aa236b-winter-2019/electrical-documentation/PandaSat Electronics.pptx

T+C Radio

Batteries

8.4 V

PMU

> 8.4V, 6W

Burn Wire Ckt

Solar panels

Burn Wires

Torque Coils

Solar Panels

Gryo/Mag

Flash Memory

MotherBoard

Data

SAMD51

Data & Power

Raspberry
PI

H-Bridges

SDR

GPS

Payload
