aa236b-winter-2019/electrical-documentation/MotherBoardOutline.pptx

Connectors

Toggle Switch

X

Solar Panel

X

TTC Antenna

Y

JTAG

Y

J

Payload

Z

P

Z

Barrel Jack

Micro USB

*Not to scale

## Slide 2

10 mm

1.6 mm

21.5 mm

~33.1 mm
