aa236b-winter-2019/electrical-documentation/MotherBoardOutline/Slide1.JPG

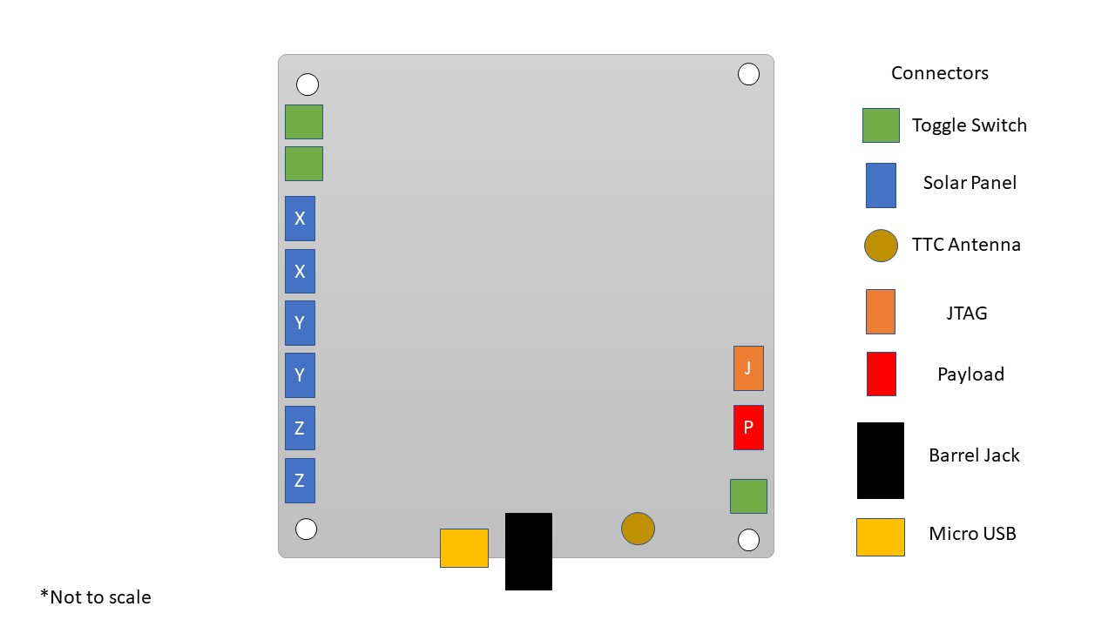
MotherBoardOutline/Slide1.JPG
