aa236b-winter-2019/electrical-documentation/MotherBoardOutline/Slide2.JPG

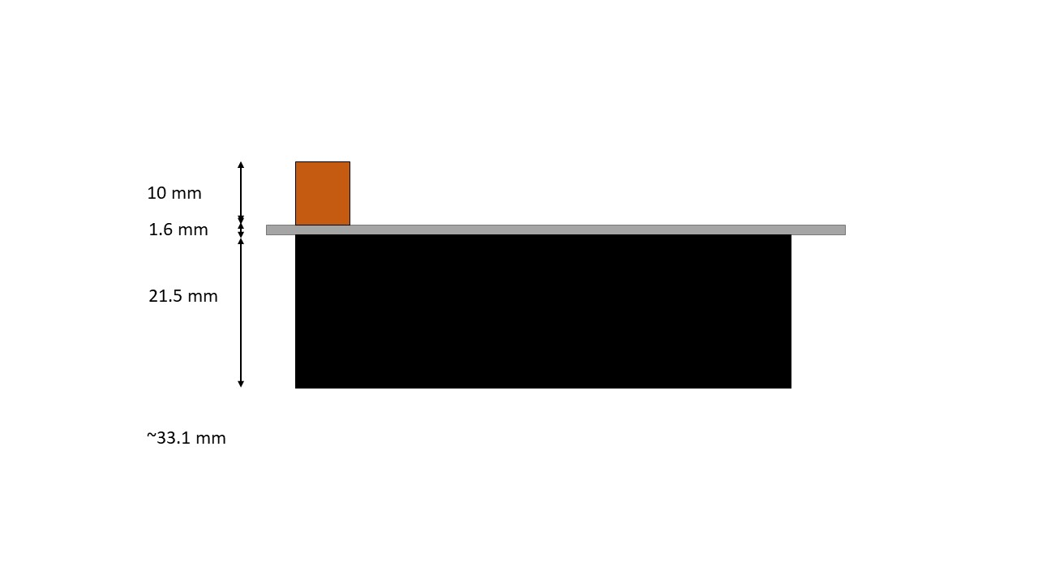
MotherBoardOutline/Slide2.JPG
