aa236b-winter-2019/electrical-documentation/PandaSat Block Diagram2.png

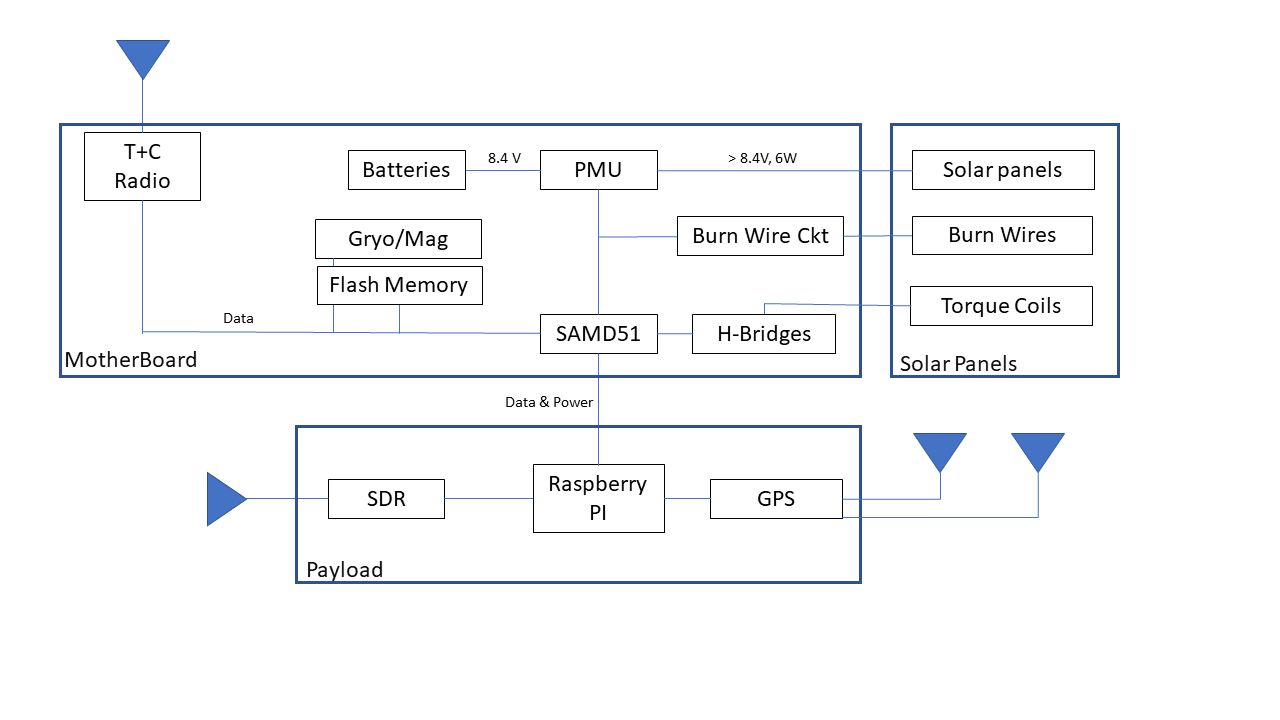
PandaSat Block Diagram2.png
