aa236b-winter-2019/electrical-documentation/PandaSat Block Diagram.png

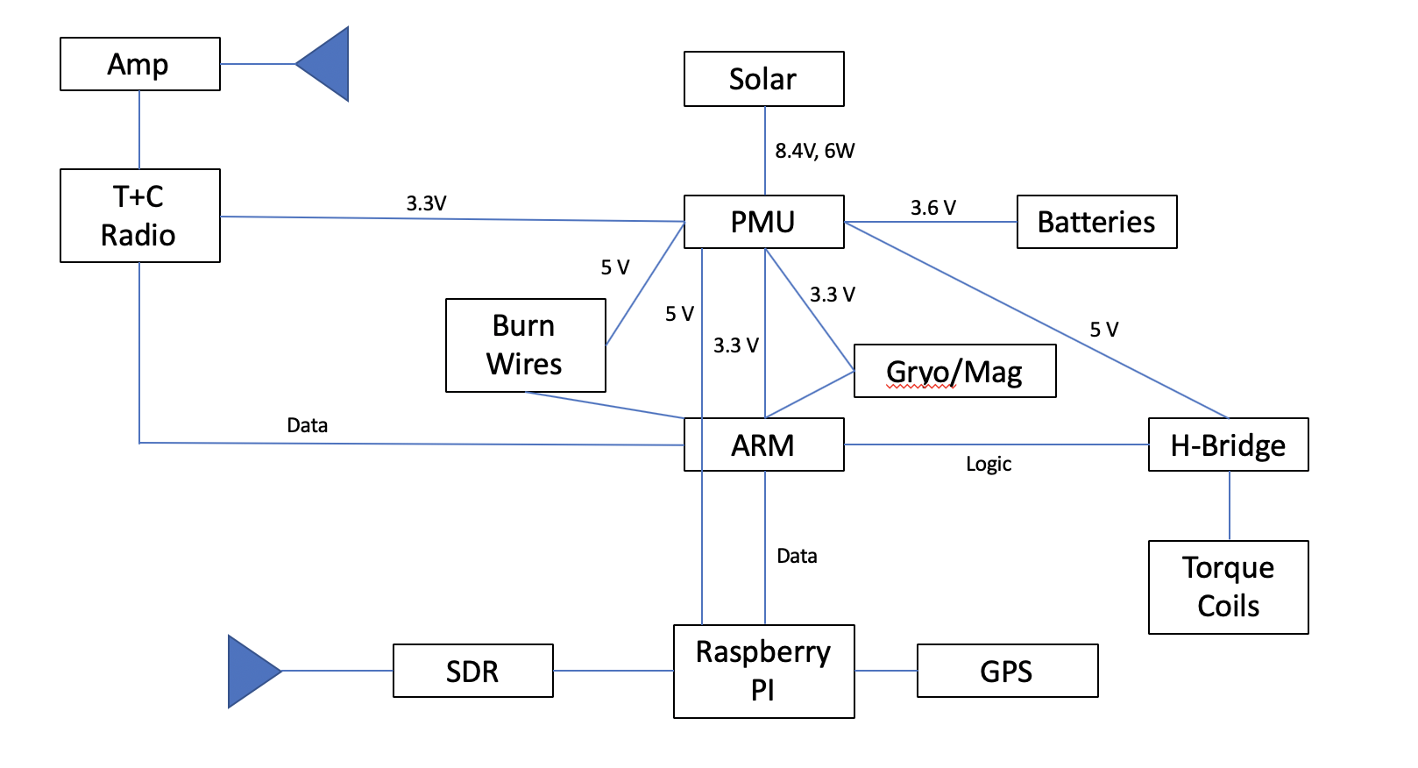
PandaSat Block Diagram.png
