aa236b-winter-2019/electrical-documentation/FlightBoardBOM_RevB.xlsx

Description | Designator | Footprint | Quantity | Supplier Part Number 1 | Manufacturer Part Number | Link | Data sheet in Repo? (Y/N) | Need
Integrated Circuits
Watchdog Timer | U1 | SOIC Narrow - 8 | 1 | 700-MAX706RESAT | MAX706RESA+T | https://www.mouser.com/ProductDetail/Maxim-Integrated/MAX706RESA%2bT | Y | 0
Battery Charging Circuit | U2 | QFN 16 | 1 | 584-LTC4121EUD#PBF | LTC4121EUD#PBF | https://www.mouser.com/ProductDetail/Analog-Devices-Linear-Technology/LTC4121EUDPBF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 | Y | 1
IMU | U3 | 24 LGA | 1 | 497-14946-1-ND | LSM9DS1TR | https://www.digikey.com/product-detail/en/stmicroelectronics/LSM9DS1TR/497-14946-1-ND/4988079 | Y | 1
Current Sense Amplifier | U4 | SOT23-5 | 1 | MAX4372TEUK+TCT-ND | MAX4372TEUK+T | https://www.digikey.com/product-detail/en/maxim-integrated/MAX4372TEUK-T/MAX4372TEUK-TCT-ND/948256 | Y | 1
Radio Module | U5 | SMD Module | 1 | RFM23BP-433-S2 | RFM23BP-433-S2 | https://www.tme.eu/en/details/rfm23bp-433-s2/rf-modules/hope-microelectronics/rfm23bp-433s2/ | Y | 0
3.3V Regulator | U6 | 14-TSSOP | 1 | 296-25332-1-ND | TPS54226PWPR | https://www.digikey.com/product-detail/en/texas-instruments/TPS54226PWPR/296-25332-1-ND/2181224 | Y | 1
MCU | U7 | 64 TQFP | 1 | ATSAMD51J19A-AUTCT-ND | ATSAMD51J19A-AUT | https://www.digikey.com/product-detail/en/microchip-technology/ATSAMD51J19A-AUT/ATSAMD51J19A-AUTCT-ND/7390180 | Y | 1
5V Regulator | U8 | SMD Module | 1 | 811-2709-1-ND | OKL-T/3-W12P-C | https://www.digikey.com/product-detail/en/murata-power-solutions-inc/OKL-T-3-W12P-C/811-2709-1-ND/3438604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 | Y | 1
4MB MRAM | U12 | 8DFN | 1 | 819-1055-ND | MR25H40MDF | https://www.digikey.com/product-detail/en/everspin-technologies-inc/MR25H40MDF/819-1055-ND/4169130 | Y | 1
H-Bridge Driver | U10, U11 | 16HTSSOP | 2 | 296-38514-5-ND | DRV8848PWP | https://www.digikey.com/product-detail/en/texas-instruments/DRV8848PWP/296-38514-5-ND/5029929 | Y | 2
Relays
Dry Contact Relay | K1 | Through Hole Mounted | 1 | PB907-ND | PE014006 | https://www.digikey.com/products/en?keywords=pe014006 | Y | 1
Transistors
N-Channel MOSFET | Q1,Q2,Q3,Q4 | SOT-23 | 4 | IRLML2803PBFCT-ND | IRLML2803TRPBF | https://www.digikey.com/product-detail/en/infineon-technologies/IRLML2803TRPBF/IRLML2803PBFCT-ND/812498 | Y | 0
P-Channel MOSFET | Q5,Q6,Q7 | 8-SOIC | 3 | IRF9310TRPBFCT-ND | IRF9310TRPBF | https://www.digikey.com/product-detail/en/infineon-technologies/IRF9310TRPBF/IRF9310TRPBFCT-ND/2202235 | Y | 3
NPN BJT | Q8 | SOT23-3 | 1 | 863-BC846BLT1G | BC846BLT1G | https://www.mouser.com/ProductDetail/ON-Semiconductor/BC846BLT1G?qs=sGAEpiMZZMtqO%252bWUGLBzePo0Ry%252bsrgua | Y | 0
P FET | Q9 | SOT23-3 | 1 | IRLML6402PBFCT-ND | IRLML6402TRPBF | https://www.digikey.com/product-detail/en/infineon-technologies/IRLML6402TRPBF/IRLML6402PBFCT-ND/812500 | Y | 1
Crystal Oscillators
32.768 kHz Oscillator | X1 | ECX-31B | 1 | ‎XC1617CT-ND‎ | ECS-.327-12.5-34B-TR | https://www.digikey.com/product-detail/en/ECS-.327-12.5-34B-TR/XC1617CT-ND/1693786/?itemSeq=286264384 | Y | 1
Diodes
5A, 40V Schottky Diode | D1,D2 | SOD-128 | 2 | 755-RBR5LAM40ATFTR | RBR5LAM40ATFTR | https://www.mouser.com/ProductDetail/ROHM-Semiconductor/RBR5LAM40ATFTR | Y | 0
1A, 30V Schottky Diode | D3 | POWERDI-123 | 1 | 621-DFLS130L | DFLS130L-7 | https://www.mouser.com/ProductDetail/Diodes-Incorporated/DFLS130L-7?qs=JV7lzlMm3yLedTETABmZ1A%3D%3D | Y | 0
Connectors
Micro SD Holder | J1 | SMT, Right Angle | 1 | WM12834CT-ND | 5031821852 | https://www.digikey.com/product-detail/en/molex-llc/5031821852/WM12834CT-ND/5823232?WT.z_cid=ref_snapeda | Y | 1
Micro USB Connector | J2,J17 | SMT, Through Hole, Right Angle | 2 | 609-4618-1-ND | 10118194-0001LF | https://www.digikey.com/product-detail/en/amphenol-icc-fci/10118194-0001LF/609-4618-1-ND/2785382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 | Y | 0
Mini USB Connector | J3 | Through Hole, Right Angle | 1 | Have a bag from Lab 64 |  |  |  | 0
SMA RF Connector | J4 | Through Hole, Vertical | 1 | ACX1230-ND | 132134 | https://www.digikey.com/product-detail/en/amphenol-rf-division/132134/ACX1230-ND/1011907 | Y | 0
Battery Holder | J5 | Through Hole, Vertical | 1 | BK-18650-PC8-ND | BK-18650-PC8 | https://www.digikey.com/product-detail/en/mpd-memory-protection-devices/BK-18650-PC8/BK-18650-PC8-ND/2330515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 | Y | 0
2x3 Male Header Vertical 2.54mm pitch | J6,J7,J8,J9,J10,J11,J12,J13,J18 | Through Hole, Vertical | 8 | 855-M20-9980345 | M20-9980345 | https://www.mouser.com/ProductDetail/Harwin/M20-9980345 | Y | 0
2 Pin Screw Terminals 3.5mm Pitch | J14,J15,J16 | Through Hole, Vertical | 3 | 474-PRT-08084 | PRT-08084 | https://www.mouser.com/ProductDetail/SparkFun/PRT-08084?qs=WyAARYrbSnalY1OfATfUQw%3D%3D | Y | 0
Inductors
56uH Fixed Inductor | L1 | 1210 | 1 | 652-CM322522-560KL | CM322522-560KL | https://www.mouser.com/ProductDetail/Bourns/CM322522-560KL | N | 0
10uH Fixed Inductor | L2 | 1210 | 1 | 652-CM322522-100KL | CM322522-100KL | https://www.mouser.com/ProductDetail/Bourns/CM322522-100KL | N | 0
3.3uH Fixed Inductor | L3 | 1210 | 1 | 652-CM322522-3R3KL | CM453232-3R3KL | https://www.mouser.com/ProductDetail/Bourns/CM453232-3R3KL | N | 0
Jumper
2 Position Male Jumper | JP6,JP7,JP8,JP9,J10 | Through Hole, Vertical | 5 | 538-22-28-4027 | 22-28-4027 | https://www.mouser.com/ProductDetail/Molex/22-28-4027 | N | 0
Capacitors
10uF SMD Ceramic | C1,C6,C8,C12,C14,C17,C18,C21,C28,C30 | SMD 0603 | 10 | 490-14372-1-ND | GRM188R61A106KE69J | https://www.digikey.com/products/en?keywords=490-14372-1-ND | N | 0
0.1uF SMD Ceramic | C2,C3,C5,C10,C13,C22,C23 | SMD 0603 | 7 | 399-5343-1-ND | C0603X104K8RACTU | https://www.digikey.com/product-detail/en/kemet/C0603X104K8RACTU/399-5343-1-ND/1842322 | N | 0
10nF SMD Ceramic | C4 | SMD 0603 | 1 | 399-11132-1-ND | C0603C103K8RACTU | https://www.digikey.com/product-detail/en/kemet/C0603C103K8RACTU/399-11132-1-ND/4357813 | N | 1
22uF SMD Ceramic | C7,C15,C16,C24 | SMD 0603 | 4 | 490-10476-1-ND | GRM188R61A226ME15D | https://www.digikey.com/product-detail/en/murata-electronics-north-america/GRM188R61A226ME15D/490-10476-1-ND/5026394 | N | 4
47uF SMD Ceramic | C9 | SMD 0603 | 1 | 490-13247-1-ND | GRM188R60J476ME15D | https://www.digikey.com/product-detail/en/murata-electronics-north-america/GRM188R60J476ME15D/490-13247-2-ND/5877410 | N | 0
2.2uF SMD Ceramic | C11,C19,C36,C37 | SMD 0603 | 4 | 1276-1085-1-ND | CL10A225KP8NNNC | https://www.digikey.com/product-detail/en/samsung-electro-mechanics/CL10A225KP8NNNC/1276-1085-1-ND/3889171 | N | 0
22nF SMD Ceramic | C20 | SMD 0603 | 1 | 399-3015-1-ND | C0402C223K8PACTU | https://www.digikey.com/product-detail/en/kemet/C0402C223K8PACTU/399-3015-1-ND/447591 | N | 1
3.3nF SMD Ceramic | C25 | SMD 0603 | 1 | 1276-2030-1-ND | CL10B332JB8NNNC | https://www.digikey.com/product-detail/en/samsung-electro-mechanics/CL10B332JB8NNNC/1276-2030-1-ND/3890116 | N | 1
1uF SMD Ceramic | C26,C27,C34,C35,C29,C31 | SMD 0603 | 6 | 1276-1182-1-ND | CL10A105KP8NNNC | https://www.digikey.com/product-detail/en/samsung-electro-mechanics/CL10A105KP8NNNC/1276-1182-1-ND/3889268 | N | 0
22pF SMD Ceramic | C32,C33 | SMD 0603 | 2 | 399-15378-1-ND | C0603C220J8GAC7867 | https://www.digikey.com/product-detail/en/kemet/C0603C220J8GAC7867/399-15378-1-ND/7386776 | N | 0
100uF SMD Ceramic | C38,C39,C40,C41,C42 | SMD 1206 | 5 | 490-9966-1ND | GRM31CE70G107ME39L | https://www.digikey.com/product-detail/en/murata-electronics-north-america/GRM31CE70G107ME39L/490-9966-1-ND/5026462 | N | 5
Resistors
43K SMD | R1 | SMD 0603 | 1 | RR08P43.0KDCT-ND | RR0816P-433D | https://www.digikey.com/product-detail/en/susumu/RR0816P-433-D/RR08P43.0KDCT-ND/432763 | N | 0
330K SMD | R2,R39 | SMD 0603 | 2 | A129718CT-ND | CRGCQ0603F330K | https://www.digikey.com/product-detail/en/te-connectivity-passive-product/CRGCQ0603F330K/A129718CT-ND/8577550 | N | 0
100K SMD | R3,R8,R9,R17,R21,R22 | SMD 0603 | 6 | RR08P100KDCT-ND | RR0816P-104-D | https://www.digikey.com/product-detail/en/susumu/RR0816P-104-D/RR08P100KDCT-ND/432772 | N | 0
40K9 SMD | R4 | SMD 0603 | 1 | YAG1658CT-ND | RT0603BRD0740K2L | https://www.digikey.com/product-detail/en/yageo/RT0603BRD0740K2L/YAG1658CT-ND/5139106 | N | 0
470K SMD | R5 | SMD 0603 | 1 | A102278CT-ND | CPF0603B470KE1 | https://www.digikey.com/product-detail/en/te-connectivity-passive-product/CPF0603B470KE1/A102278CT-ND/2728653 | N | 0
4K7 SMD | R6,R11,R15,R19,R25,R26 | SMD 0603 | 6 | 311-4.7KGRCT-ND | RC0603JR-074K7L | https://www.digikey.com/product-detail/en/yageo/RC0603JR-074K7L/311-4.7KGRCT-ND/729732 | N | 0
6K04 SMD | R7 | SMD 0603 | 1 | 311-6.04KDCT-ND | RT0603DRD076K04L | https://www.digikey.com/product-detail/en/yageo/RT0603DRD076K04L/311-6.04KDCT-ND/1035869 | N | 0
10K SMD | R10,R13,R16,R18,R24,R27,R34,R37 | SMD 0603 | 8 | RNCP0603FTD10K0CT-ND | RNCP0603FTD10K0 | https://www.digikey.com/product-detail/en/stackpole-electronics-inc/RNCP0603FTD10K0/RNCP0603FTD10K0CT-ND/2240478 | N | 0
73K2 SMD | R12 | SMD 0603 | 1 | 311-73.2KHRCT-ND | RC0603FR-0773K2L | https://www.digikey.com/product-detail/en/yageo/RC0603FR-0773K2L/311-73.2KHRCT-ND/730321 | N | 0
22K1 SMD | R14 | SMD 0603 | 1 | YAG1590TR-ND | RT0603BRD0722K1L | https://www.digikey.com/product-detail/en/yageo/RT0603BRD0722K1L/YAG1590TR-ND/1072367 | N | 0
3K3 SMD | R20 | SMD 0603 | 1 | 311-3.30KHRCT-ND | RC0603FR-073K3L | https://www.digikey.com/product-detail/en/yageo/RC0603FR-073K3L/311-3.30KHRCT-ND/730073 | N | 0
1K34 SMD | R23 | SMD 0603 | 1 | 311-1.33KHRCT-ND | RC0603FR-071K33L | https://www.digikey.com/product-detail/en/yageo/RC0603FR-071K33L/311-1.33KHRCT-ND/729806 | N | 0
62R SMD | R32 | SMD 0603 | 1 | 311-62GRCT-ND | RC0603JR-0762RL | https://www.digikey.com/product-detail/en/yageo/RC0603JR-0762RL/311-62GRCT-ND/729764 | N | 0
130R SMD | R33 | SMD 0603 | 1 | 311-130GRCT-ND | RC0603JR-07130RL | https://www.digikey.com/product-detail/en/yageo/RC0603JR-07130RL/311-130GRCT-ND/729657 | N | 0
0R025 SMD | R35 | SMD 2512 | 1 | CSR1206FK25L0TR-ND | CSR1206FK25L0 | https://www.digikey.com/product-detail/en/stackpole-electronics-inc/CSR1206FK25L0/CSR1206FK25L0TR-ND/1646093 | N | 0
665K SMD | R38 | SMD 0603 | 1 | 311-665KHRCT-ND | RC0603FR-07665KL | https://www.digikey.com/product-detail/en/yageo/RC0603FR-07665KL/311-665KHRCT-ND/730297 | N | 1
330R SMD | R28,29,30,31 | SMD 0603 | 4 | 311-330HRCT-ND | RC0603FR-07330RL | https://www.digikey.com/product-detail/en/yageo/RC0603FR-07330RL/311-330HRCT-ND/730109 | N | 4
LED
Red LED SMD | LED1, LED2, LED3, LED4, LED5, LED6 | SMD 0603 | 6 | 67-1551-1-ND | SML-LX0603SRW-TR | https://www.digikey.com/product-detail/en/lumex-opto-components-inc/SML-LX0603SRW-TR/67-1551-1-ND/304364 | N | 6
Switch
Reset Button | B1 | BTN_KMR2_4.6X2.8 | 1 | CKN10246CT-ND | KMR231NG LFS | https://www.digikey.com/product-detail/en/c-k/KMR231NG-LFS/CKN10246CT-ND/2176497 |  | 1
