aa236b-winter-2019/electrical-documentation/Order.xlsx

Description | Designator | Footprint | Quantity | Supplier Part Number 1 | Manufacturer Part Number | Link | Data sheet in Repo? (Y/N)
Integrated Circuits
Watchdog Timer | U1 | SOIC Narrow - 8 | 3 | 700-MAX706RESAT | MAX706RESA+T | https://www.mouser.com/ProductDetail/Maxim-Integrated/MAX706RESA%2bT | Y
Battery Charging Circuit | U2 | QFN 16 | 3 | 584-LTC4121EUD#PBF | LTC4121EUD#PBF | https://www.mouser.com/ProductDetail/Analog-Devices-Linear-Technology/LTC4121EUDPBF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 | Y
IMU | U3 | 24 LGA | 3 | 497-14946-1-ND | LSM9DS1TR | https://www.digikey.com/product-detail/en/stmicroelectronics/LSM9DS1TR/497-14946-1-ND/4988079 | Y
Current Sense Amplifier | U4 | SOT23-5 | 3 | MAX4372TEUK+TCT-ND | MAX4372TEUK+T | https://www.digikey.com/product-detail/en/maxim-integrated/MAX4372TEUK-T/MAX4372TEUK-TCT-ND/948256 | Y
Radio Module | U5 | SMD Module | 3 | RFM23BP-433-S2 | RFM23BP-433-S2 | https://www.tme.eu/en/details/rfm23bp-433-s2/rf-modules/hope-microelectronics/rfm23bp-433s2/ | Y
3.3V Regulator | U6 | 14-TSSOP | 3 | 296-25332-1-ND | TPS54226PWPR | https://www.digikey.com/product-detail/en/texas-instruments/TPS54226PWPR/296-25332-1-ND/2181224 | Y
MCU | U7 | 64 TQFP | 3 | ATSAMD51J19A-AUTCT-ND | ATSAMD51J19A-AUT | https://www.digikey.com/product-detail/en/microchip-technology/ATSAMD51J19A-AUT/ATSAMD51J19A-AUTCT-ND/7390180 | Y
5V Regulator | U8 | SMD Module | 3 | 811-2709-1-ND | OKL-T/3-W12P-C | https://www.digikey.com/product-detail/en/murata-power-solutions-inc/OKL-T-3-W12P-C/811-2709-1-ND/3438604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 | Y
2MB Serial Flash | U9 | 8-SOIC | 3 | 870-IS25WP016D-JNLE | IS25WP016D-JNLE | https://www.mouser.com/ProductDetail/ISSI/IS25WP016D-JNLE | Y
H-Bridge Driver | U10, U11 | 16HTSSOP | 6 | 296-38514-5-ND | DRV8848PWP | https://www.digikey.com/product-detail/en/texas-instruments/DRV8848PWP/296-38514-5-ND/5029929 | Y
Relays
Dry Contact Relay | K1 | Through Hole Mounted | 3 | PB907-ND | PE014006 | https://www.digikey.com/products/en?keywords=pe014006 | Y
Transistors
N-Channel MOSFET | Q1,Q2,Q3,Q4 | SOT-23 | 12 | IRLML2803PBFCT-ND | IRLML2803TRPBF | https://www.digikey.com/product-detail/en/infineon-technologies/IRLML2803TRPBF/IRLML2803PBFCT-ND/812498 | Y
P-Channel MOSFET | Q5,Q6,Q7 | 8-SOIC | 9 | IRF9310TRPBFCT-ND | IRF9310TRPBF | https://www.digikey.com/product-detail/en/infineon-technologies/IRF9310TRPBF/IRF9310TRPBFCT-ND/2202235 | N
NPN BJT | Q8 | SOT23-3 | 10 | 863-BC846BLT1G | BC846BLT1G | https://www.mouser.com/ProductDetail/ON-Semiconductor/BC846BLT1G?qs=sGAEpiMZZMtqO%252bWUGLBzePo0Ry%252bsrgua | N
Crystal Oscillators
32.768 kHz Oscillator | X1 | 4-SMD | 3 | XC2826CT-ND | ECS-327ATQMV-AS-TR | https://www.digikey.com/product-detail/en/ecs-inc/ECS-327ATQMV-AS-TR/XC2826CT-ND/9385280 | N
Diodes
5A, 40V Schottky Diode | D1,D2 | SOD-128 | 6 | 755-RBR5LAM40ATFTR | RBR5LAM40ATFTR | https://www.mouser.com/ProductDetail/ROHM-Semiconductor/RBR5LAM40ATFTR | Y
1A, 30V Schottky Diode | D3 | POWERDI-123 | 3 | 621-DFLS130L | DFLS130L-7 | https://www.mouser.com/ProductDetail/Diodes-Incorporated/DFLS130L-7?qs=JV7lzlMm3yLedTETABmZ1A%3D%3D | N
Connectors
Micro SD Holder | J1 | SMT, Right Angle | 3 | WM12834CT-ND | 5031821852 | https://www.digikey.com/product-detail/en/molex-llc/5031821852/WM12834CT-ND/5823232?WT.z_cid=ref_snapeda | N
Micro USB Connector | J2,J17 | SMT, Through Hole, Right Angle | 6 | 609-4618-1-ND | 10118194-0001LF | https://www.digikey.com/product-detail/en/amphenol-icc-fci/10118194-0001LF/609-4618-1-ND/2785382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 | N
DC Barrel Jack | J3 | SMD | 3 | CP-036AHPJTR-ND | PJ-036AH-SMT-TR | https://www.digikey.com/product-detail/en/cui-inc/PJ-036AH-SMT-TR/CP-036AHPJTR-ND/1530971 | N
SMA RF Connector | J4 | Through Hole, Vertical | 3 | ACX1230-ND | 132134 | https://www.digikey.com/product-detail/en/amphenol-rf-division/132134/ACX1230-ND/1011907 | N
Battery Holder | J5 | Through Hole, Vertical | 3 | BK-18650-PC8-ND | BK-18650-PC8 | https://www.digikey.com/product-detail/en/mpd-memory-protection-devices/BK-18650-PC8/BK-18650-PC8-ND/2330515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 | N
2x3 Male Header Vertical 2.54mm pitch | J6,J7,J8,J9,J10,J11,J12,J13,J18 | Through Hole, Vertical | 27 | 855-M20-9980345 | M20-9980345 | https://www.mouser.com/ProductDetail/Harwin/M20-9980345 | N
2 Pin Screw Terminals 3.5mm Pitch | J14,J15,J16 | Through Hole, Vertical | 9 | 474-PRT-08084 | PRT-08084 | https://www.digikey.com/product-detail/en/te-connectivity-amp-connectors/640456-2/A1921-ND/109003 | N
Inductors
56uH Fixed Inductor | L1 | 1210 | 3 | 652-CM322522-560KL | CM322522-560KL | https://www.mouser.com/ProductDetail/Bourns/CM322522-560KL | N
10uH Fixed Inductor | L2 | 1210 | 3 | 652-CM322522-100KL | CM322522-100KL | https://www.mouser.com/ProductDetail/Bourns/CM322522-100KL | N
3.3uH Fixed Inductor | L3 | 1210 | 3 | 652-CM322522-3R3KL | CM453232-3R3KL | https://www.mouser.com/ProductDetail/Bourns/CM453232-3R3KL | N
Fuses
6V 3A Reset Fuse | F1 | 2-SMD | 3 | SMD300F-2CT-ND | SMD300F-2 | https://www.digikey.com/product-detail/en/littelfuse-inc/SMD300F-2/SMD300F-2CT-ND/1045852 | N
Jumper
2 Position Male Jumper | JP6,JP7,JP8,JP9 | Through Hole, Vertical | 12 | 538-22-28-4027 | 22-28-4027 | https://www.mouser.com/ProductDetail/Molex/22-28-4027 | N
Capacitors
10uF SMD Ceramic | C1,C6,C8,C12,C14,C17,C18,C21,C28,C30 | SMD 0603 | 30 | 490-14372-1-ND | GRM188R61A106KE69J | https://www.digikey.com/products/en?keywords=490-14372-1-ND | N
0.1uF SMD Ceramic | C2,C3,C5,C10,C13,C22,C23 | SMD 0603 | 21 | 399-5343-1-ND | C0603X104K8RACTU | https://www.digikey.com/product-detail/en/kemet/C0603X104K8RACTU/399-5343-1-ND/1842322 | N
10nF SMD Ceramic | C4 | SMD 0603 | 10 | 399-11132-1-ND | C0603C103K8RACTU | https://www.digikey.com/product-detail/en/kemet/C0603C103K8RACTU/399-11132-1-ND/4357813 | N
22uF SMD Ceramic | C7,C15,C16,C24 | SMD 0603 | 12 | 490-10476-1-ND | GRM188R61A226ME15D | https://www.digikey.com/product-detail/en/murata-electronics-north-america/GRM188R61A226ME15D/490-10476-1-ND/5026394 | N
47uF SMD Ceramic | C9 | SMD 0603 | 10 | 490-13247-1-ND | GRM188R60J476ME15D | https://www.digikey.com/product-detail/en/murata-electronics-north-america/GRM188R60J476ME15D/490-13247-2-ND/5877410 | N
2.2uF SMD Ceramic | C11,C19,C36,C37 | SMD 0603 | 12 | 1276-1085-1-ND | CL10A225KP8NNNC | https://www.digikey.com/product-detail/en/samsung-electro-mechanics/CL10A225KP8NNNC/1276-1085-1-ND/3889171 | N
22nF SMD Ceramic | C20 | SMD 0603 | 10 | 399-3015-1-ND | C0402C223K8PACTU | https://www.digikey.com/product-detail/en/kemet/C0402C223K8PACTU/399-3015-1-ND/447591 | N
3.3nF SMD Ceramic | C25 | SMD 0603 | 10 | 311-3691-1-ND | CC0201KRX7R6BB332 | https://www.digikey.com/product-detail/en/yageo/CC0201KRX7R6BB332/311-3691-1-ND/8024780 | N
1uF SMD Ceramic | C26,C27,C34,C35,C29,C31 | SMD 0603 | 18 | 1276-1182-1-ND | CL10A105KP8NNNC | https://www.digikey.com/product-detail/en/samsung-electro-mechanics/CL10A105KP8NNNC/1276-1182-1-ND/3889268 | N
22pF SMD Ceramic | C32,C33 | SMD 0603 | 10 | 399-15378-1-ND | C0603C220J8GAC7867 | https://www.digikey.com/product-detail/en/kemet/C0603C220J8GAC7867/399-15378-1-ND/7386776 | N
100uF SMD Ceramic | C38,C39,C40,C41,C42 | SMD 1206 | 15 | 490-9966-1ND | GRM31CE70G107ME39L | https://www.digikey.com/product-detail/en/murata-electronics-north-america/GRM31CE70G107ME39L/490-9966-1-ND/5026462 | N
Resistors
43K SMD | R1 | SMD 0603 | 10 | RR08P43.0KDCT-ND | RR0816P-433D | https://www.digikey.com/product-detail/en/susumu/RR0816P-433-D/RR08P43.0KDCT-ND/432763 | N
330K SMD | R2 | SMD 0603 | 10 | A129718CT-ND | CRGCQ0603F330K | https://www.digikey.com/product-detail/en/te-connectivity-passive-product/CRGCQ0603F330K/A129718CT-ND/8577550 | N
100K SMD | R3,R8,R9,R17,R21,R22 | SMD 0603 | 18 | RR08P100KDCT-ND | RR0816P-104-D | https://www.digikey.com/product-detail/en/susumu/RR0816P-104-D/RR08P100KDCT-ND/432772 | N
40K9 SMD | R4 | SMD 0603 | 10 | YAG1658CT-ND | RT0603BRD0740K2L | https://www.digikey.com/product-detail/en/yageo/RT0603BRD0740K2L/YAG1658CT-ND/5139106 | N | note could only find 40K2
470K SMD | R5 | SMD 0603 | 10 | A102278CT-ND | CPF0603B470KE1 | https://www.digikey.com/product-detail/en/te-connectivity-passive-product/CPF0603B470KE1/A102278CT-ND/2728653 | N
4K7 SMD | R6,R11,R15,R19,R25,R26 | SMD 0603 | 18 | 311-4.7KGRCT-ND | RC0603JR-074K7L | https://www.digikey.com/product-detail/en/yageo/RC0603JR-074K7L/311-4.7KGRCT-ND/729732 | N
6K04 SMD | R7 | SMD 0603 | 10 | 311-6.04KDCT-ND | RT0603DRD076K04L | https://www.digikey.com/product-detail/en/yageo/RT0603DRD076K04L/311-6.04KDCT-ND/1035869 | N
10K SMD | R10,R13,R16,R18,R24,R27,R34,R36,R37 | SMD 0603 | 27 | RNCP0603FTD10K0CT-ND | RNCP0603FTD10K0 | https://www.digikey.com/product-detail/en/stackpole-electronics-inc/RNCP0603FTD10K0/RNCP0603FTD10K0CT-ND/2240478 | N
73K2 SMD | R12 | SMD 0603 | 10 | 311-73.2KHRCT-ND | RC0603FR-0773K2L | https://www.digikey.com/product-detail/en/yageo/RC0603FR-0773K2L/311-73.2KHRCT-ND/730321 | N
22K1 SMD | R14 | SMD 0603 | 10 | YAG1590TR-ND | RT0603BRD0722K1L | https://www.digikey.com/product-detail/en/yageo/RT0603BRD0722K1L/YAG1590TR-ND/1072367 | N
3K3 SMD | R20 | SMD 0603 | 10 | 311-3.30KHRCT-ND | RC0603FR-073K3L | https://www.digikey.com/product-detail/en/yageo/RC0603FR-073K3L/311-3.30KHRCT-ND/730073 | N
1K34 SMD | R23 | SMD 0603 | 10 | 311-1.33KHRCT-ND | RC0603FR-071K33L | https://www.digikey.com/product-detail/en/yageo/RC0603FR-071K33L/311-1.33KHRCT-ND/729806 | N | note could only find 1K35
62R SMD | R28,R29,R30,R31,R32 | SMD 0603 | 15 | 311-62GRCT-ND | RC0603JR-0762RL | https://www.digikey.com/product-detail/en/yageo/RC0603JR-0762RL/311-62GRCT-ND/729764 | N
130R SMD | R33 | SMD 0603 | 10 | 311-130GRCT-ND | RC0603JR-07130RL | https://www.digikey.com/product-detail/en/yageo/RC0603JR-07130RL/311-130GRCT-ND/729657 | N
0R025 SMD | R35 | SMD 2512 | 10 | CSR1206FK25L0TR-ND | CSR1206FK25L0 | https://www.digikey.com/product-detail/en/stackpole-electronics-inc/CSR1206FK25L0/CSR1206FK25L0TR-ND/1646093 | N
2M1 SMD | R38 | SMD 0603 | 10 | 541-2.10MHCT-ND | CRCW06032M10FKEA | https://www.digikey.com/product-detail/en/vishay-dale/CRCW06032M10FKEA/541-2.10MHCT-ND/1180186 | N
845K SMD | R39 | SMD 0603 | 10 | 311-845KHRCT-ND | RC0603FR-07845KL | https://www.digikey.com/product-detail/en/yageo/RC0603FR-07845KL/311-845KHRCT-ND/730357 | N
