aa236b-winter-2019/electrical-documentation/Solar Panel/BOMs/SolarPanel_X.xlsx

Item | Description | Price | Number | Supplier
M20-8760342 | CONN HEADER SMD 6POS 2.54MM | 0.43 | 1 | Digikey
SLMD121H04L | MONO SOLAR CELL 43MM X 14MM | 5.9 | 10 | Digikey
