aa236b-winter-2019/electrical-documentation/(threads)

Thread 2 (2019-02-11):

###Solar Panels

GathererA, 2019-02-11:
-[ ] Finalize and order side y solar panels
-[ ] update power budget with more realistic consideration for solar cell power generation
-[ ] Begin design of top and bottom panels

GathererA, 2019-02-20:
All good! Changed the diode location and regenerated the gerbers

Closed 2019-02-20.
