aa236b-winter-2019/electrical-documentation/Firmware/variant.cpp

/*
  Copyright (c) 2014-2015 Arduino LLC.  All right reserved.

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
  You should have received a copy of the GNU Lesser General Public
  License along with this library; if not, write to the Free Software
  Foundation, Inc., 51 Franklin St, Fifth Floor, Boston, MA  02110-1301  USA
*/

#include "variant.h"

/*
 * Pins descriptions
 */

//TCC0 IOSET 6
//TCC1 IOSET 1
//TC0 IOSET 1
//TC1 IOSET 1
//TC2 IOSET 2
//TC3 IOSET 1
//TC4 IOSET 1
const PinDescription g_APinDescription[]=
{
  // 0..13 - Digital pins
  // ----------------------
  // 0/1 - SERCOM/UART (Serial1)
  { PORTB, 17, PIO_SERCOM, PIN_ATTR_PWM_G, No_ADC_Channel, TCC0_CH4, NOT_ON_TIMER, EXTERNAL_INT_1 }, // RX: SERCOM5/PAD[1]
  { PORTB, 16, PIO_SERCOM, PIN_ATTR_PWM_G, No_ADC_Channel, TCC0_CH5, NOT_ON_TIMER, EXTERNAL_INT_0 }, // TX: SERCOM5/PAD[0]

// 2
  { PORTB, 7, PIO_DIGITAL, PIN_ATTR_NONE, No_ADC_Channel, NOT_ON_PWM, NOT_ON_TIMER, EXTERNAL_INT_NONE }, // BURN_RELAY_A
//3 
  { PORTB,  11, PIO_DIGITAL, PIN_ATTR_NONE, No_ADC_Channel, NOT_ON_PWM, NOT_ON_TIMER, EXTERNAL_INT_NONE  }, //SPI_CS_MRAM
//4
  { PORTB, 14, PIO_DIGITAL, PIN_ATTR_TIMER, No_ADC_Channel, NOT_ON_PWM, NOT_ON_TIMER, EXTERNAL_INT_NONE }, //ENAB_BURN1
//5
  { PORTB, 15, PIO_DIGITAL, PIN_ATTR_TIMER, No_ADC_Channel, NOT_ON_PWM, NOT_ON_TIMER, EXTERNAL_INT_NONE }, //ENAB_BURN2
//6
  { PORTB,  5, PIO_DIGITAL, PIN_ATTR_NONE, No_ADC_Channel, NOT_ON_PWM, NOT_ON_TIMER, EXTERNAL_INT_NONE }, // MXZ_EN
//7
  { PORTA,  18, PIO_DIGITAL, PIN_ATTR_NONE, No_ADC_Channel, NOT_ON_PWM, NOT_ON_TIMER, EXTERNAL_INT_NONE }, // MINX_1
//8
  { PORTA,  19, PIO_DIGITAL, PIN_ATTR_NONE, No_ADC_Channel, NOT_ON_PWM, NOT_ON_TIMER, EXTERNAL_INT_NONE }, // MINX_2
//9
  { PORTA,  22, PIO_DIGITAL, PIN_ATTR_NONE, No_ADC_Channel, NOT_ON_PWM, NOT_ON_TIMER, EXTERNAL_INT_NONE }, // MINZ_1
//10
  { PORTA,  23, PIO_DIGITAL, PIN_ATTR_NONE, No_ADC_Channel, NOT_ON_PWM, NOT_ON_TIMER, EXTERNAL_INT_NONE }, // MINZ_2
//11
  { PORTA, 9, PIO_DIGITAL, PIN_ATTR_PWM_G, No_ADC_Channel, TCC0_CH3, TC4_CH1, EXTERNAL_INT_7 }, // LED1
//12
  { PORTA, 10, PIO_DIGITAL, PIN_ATTR_NONE, No_ADC_Channel, NOT_ON_PWM, NOT_ON_TIMER, EXTERNAL_INT_NONE }, // LED2
//13
  { PORTA, 11, PIO_DIGITAL, PIN_ATTR_NONE, No_ADC_Channel, NOT_ON_PWM, NOT_ON_TIMER, EXTERNAL_INT_NONE }, // LED3
//14
  { PORTB, 6, PIO_DIGITAL, PIN_ATTR_NONE, No_ADC_Channel, NOT_ON_PWM, NOT_ON_TIMER, EXTERNAL_INT_NONE }, // MY_EN
//15
  { PORTA,  20, PIO_DIGITAL, PIN_ATTR_NONE, No_ADC_Channel, NOT_ON_PWM, NOT_ON_TIMER, EXTERNAL_INT_NONE }, // MINY_1
//16
  { PORTA,  21, PIO_DIGITAL, PIN_ATTR_NONE, No_ADC_Channel, NOT_ON_PWM, NOT_ON_TIMER, EXTERNAL_INT_NONE }, // MINY_2
//17
  { PORTB,  1, PIO_DIGITAL, PIN_ATTR_NONE, No_ADC_Channel, NOT_ON_PWM, NOT_ON_TIMER, EXTERNAL_INT_NONE }, // PL_PWR_ENABLE
//18
  { PORTB,  2, PIO_DIGITAL, PIN_ATTR_NONE, No_ADC_Channel, NOT_ON_PWM, NOT_ON_TIMER, EXTERNAL_INT_NONE }, // PL_ENABLE
//19
  { PORTB,  0, PIO_DIGITAL, PIN_ATTR_NONE, No_ADC_Channel, NOT_ON_PWM, NOT_ON_TIMER, EXTERNAL_INT_NONE }, // 5V_EN
//20
  { PORTA,  5, PIO_ANALOG, PIN_ATTR_ANALOG, ADC_Channel5, NOT_ON_PWM, NOT_ON_TIMER, EXTERNAL_INT_5 }, //V_BATT_LV

//  { PORTA,  4, PIO_ANALOG, (PIN_ATTR_ANALOG|PIN_ATTR_PWM_E), ADC_Channel4, TC0_CH0, TC0_CH0, EXTERNAL_INT_6 },


  // A6, D20 - VDiv!
 // { PORTB,  1, PIO_ANALOG, PIN_ATTR_ANALOG, ADC_Channel13, NOT_ON_PWM, NOT_ON_TIMER, EXTERNAL_INT_1 },


  // 21..22 I2C pins (SDA/SCL)
  // ----------------------
  { PORTA, 12, PIO_SERCOM, PIN_ATTR_PWM_E, No_ADC_Channel, TC2_CH0, TC2_CH0, EXTERNAL_INT_12 }, // SDA: SERCOM2/PAD[0]
  { PORTA, 13, PIO_SERCOM, PIN_ATTR_PWM_E, No_ADC_Channel, TC2_CH1, TC2_CH1, EXTERNAL_INT_13 }, // SCL: SERCOM2/PAD[1]

  // 23..25 - SPI pins (MISO,MOSI,SCK)
  // ----------------------
  { PORTB, 22, PIO_SERCOM, PIN_ATTR_DIGITAL, No_ADC_Channel, NOT_ON_PWM, NOT_ON_TIMER, EXTERNAL_INT_6 }, // MISO: SERCOM1/PAD[2]
  { PORTB, 23, PIO_SERCOM, PIN_ATTR_DIGITAL, No_ADC_Channel, NOT_ON_PWM, NOT_ON_TIMER, EXTERNAL_INT_7 }, // MOSI: SERCOM1/PAD[3]
  { PORTA, 17, PIO_SERCOM, PIN_ATTR_DIGITAL, No_ADC_Channel, NOT_ON_PWM, NOT_ON_TIMER, EXTERNAL_INT_1 }, // SCK: SERCOM1/PAD[1]

  // 26..27 - RX/TX LEDS  -- unused
  // --------------------
  { NOT_A_PORT, 0, PIO_NOT_A_PIN, PIN_ATTR_NONE, No_ADC_Channel, NOT_ON_PWM, NOT_ON_TIMER, EXTERNAL_INT_NONE },
  { NOT_A_PORT, 0, PIO_NOT_A_PIN, PIN_ATTR_NONE, No_ADC_Channel, NOT_ON_PWM, NOT_ON_TIMER, EXTERNAL_INT_NONE },

  // 28..30 - USB
  // --------------------
  { NOT_A_PORT, 0, PIO_NOT_A_PIN, PIN_ATTR_NONE, No_ADC_Channel, NOT_ON_PWM, NOT_ON_TIMER, EXTERNAL_INT_NONE }, // USB Host enable DOES NOT EXIST ON THIS BOARD
  { PORTA, 24, PIO_COM, PIN_ATTR_NONE, No_ADC_Channel, NOT_ON_PWM, NOT_ON_TIMER, EXTERNAL_INT_NONE }, // USB/DM
  { PORTA, 27, PIO_COM, PIN_ATTR_NONE, No_ADC_Channel, NOT_ON_PWM, NOT_ON_TIMER, EXTERNAL_INT_NONE }, // USB/DP

  // 31 (AREF)
  { PORTA, 3, PIO_ANALOG, PIN_ATTR_ANALOG, No_ADC_Channel, NOT_ON_PWM, NOT_ON_TIMER, EXTERNAL_INT_NONE }, // DAC/VREFP

  // ----------------------
  // 32..33 - Alternate use of A0 (DAC output)
  { PORTA,  2, PIO_ANALOG, PIN_ATTR_ANALOG, DAC_Channel0, NOT_ON_PWM, NOT_ON_TIMER, EXTERNAL_INT_NONE }, // DAC/VOUT0
  { PORTA,  5, PIO_ANALOG, PIN_ATTR_ANALOG, DAC_Channel1, NOT_ON_PWM, NOT_ON_TIMER, EXTERNAL_INT_NONE }, // DAC/VOUT1

  // ----------------------
  // 34..39 QSPI (SCK, CS, IO0, IO1, IO2, IO3)
  { PORTB, 10, PIO_COM, PIN_ATTR_NONE, No_ADC_Channel, NOT_ON_PWM, NOT_ON_TIMER, EXTERNAL_INT_NONE },
  { PORTB, 11, PIO_COM, PIN_ATTR_NONE, No_ADC_Channel, NOT_ON_PWM, NOT_ON_TIMER, EXTERNAL_INT_NONE },
  { PORTA, 8, PIO_COM, PIN_ATTR_NONE, No_ADC_Channel, NOT_ON_PWM, NOT_ON_TIMER, EXTERNAL_INT_NONE },
  { PORTA, 9, PIO_COM, PIN_ATTR_NONE, No_ADC_Channel, NOT_ON_PWM, NOT_ON_TIMER, EXTERNAL_INT_NONE },
  { PORTA, 10, PIO_COM, PIN_ATTR_NONE, No_ADC_Channel, NOT_ON_PWM, NOT_ON_TIMER, EXTERNAL_INT_NONE },
  { PORTA, 11, PIO_COM, PIN_ATTR_NONE, No_ADC_Channel, NOT_ON_PWM, NOT_ON_TIMER, EXTERNAL_INT_NONE },
} ;

const void* g_apTCInstances[TCC_INST_NUM+TC_INST_NUM]={ TCC0, TCC1, TCC2, TCC3, TCC4, TC0, TC1, TC2, TC3, TC4, TC5 } ;
const uint32_t GCLK_CLKCTRL_IDs[TCC_INST_NUM+TC_INST_NUM] = { TCC0_GCLK_ID, TCC1_GCLK_ID, TCC2_GCLK_ID, TCC3_GCLK_ID, TCC4_GCLK_ID, TC0_GCLK_ID, TC1_GCLK_ID, TC2_GCLK_ID, TC3_GCLK_ID, TC4_GCLK_ID, TC5_GCLK_ID } ;

// Multi-serial objects instantiation
SERCOM sercom0( SERCOM0 ) ;
SERCOM sercom1( SERCOM1 ) ;
SERCOM sercom2( SERCOM2 ) ;
SERCOM sercom3( SERCOM3 ) ;
SERCOM sercom4( SERCOM4 ) ;
SERCOM sercom5( SERCOM5 ) ;

Uart Serial1( &sercom5, PIN_SERIAL1_RX, PIN_SERIAL1_TX, PAD_SERIAL1_RX, PAD_SERIAL1_TX ) ;

void SERCOM5_0_Handler()
{
  Serial1.IrqHandler();
}
void SERCOM5_1_Handler()
{
  Serial1.IrqHandler();
}
void SERCOM5_2_Handler()
{
  Serial1.IrqHandler();
}
void SERCOM5_3_Handler()
{
  Serial1.IrqHandler();
}
