aa236b-winter-2019/electrical-documentation/(commit log)

2019-01-16 Added Kicksat1 legacy solar panel schematics
    [SolarPanel.brd, SolarPanel.sch]
2019-02-02 Added BOM
    [SolarPanel_X.xlsx]
2019-02-02 Added BOM SpreadSheet [blank]
    [FlightBoardBOM.xlsx]
2019-02-04 Updated BOM. TODO: Add resistors, caps, inductors, fuses and jumpers
    [FlightBoardBOM.xlsx]
2019-02-04 Updated BOM
    [FlightBoardBOM.xlsx]
2019-02-05 Changed NFET, added inductors and fuses
    [FlightBoardBOM.xlsx]
2019-02-05 Changed min order on cheap components to 10
    [Order.xlsx]
2019-02-06 Updated 'Order' to match BOM
    [Order.xlsx]
2019-02-07 Corrected foot/rail switch parts
    [FlightBoardBOM.xlsx, Order.xlsx]
2019-02-07 Added datasheets
    [FlightBoardBOM.xlsx]
2019-02-12 Added GPS antenna datasheet
2019-02-12 BOM Updates
    [FlightBoardBOM.xlsx]
2019-03-01 Add files via upload
    New Power Budget. MicroSD values based on SanDisk, need to check if this is the actual microSD being used.
    [PowerBudget.xlsx]
2019-03-01 Updated Power Budget (not based on testing)
    Need to update microSD values. Each operating mode is a tab. Each value in operating mode column is a drop-down list, select different operating mode changes all power/notes/etc. to match new operating mode.
    [PowerBudget.xlsx]
2019-03-04 Made BOM for Rev2 MB
    [FlightBoardBOM_RevB.xlsx]
